astralis12/Cubesat/models/Activity Diagram (Telemetry Cycle).pdf

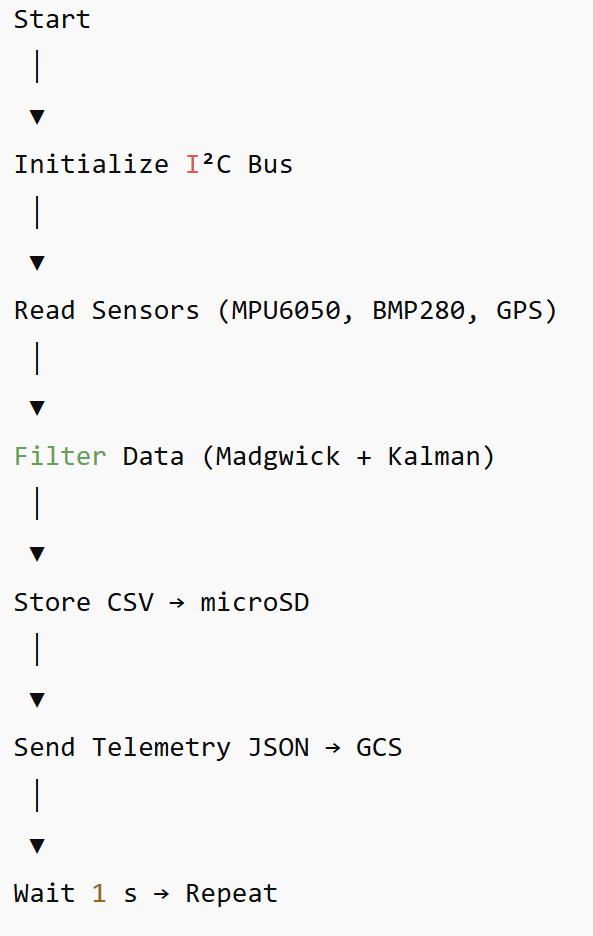
[picture p3: page 1]
