astralis12/Cubesat/models/Block Definition Diagramm.pdf

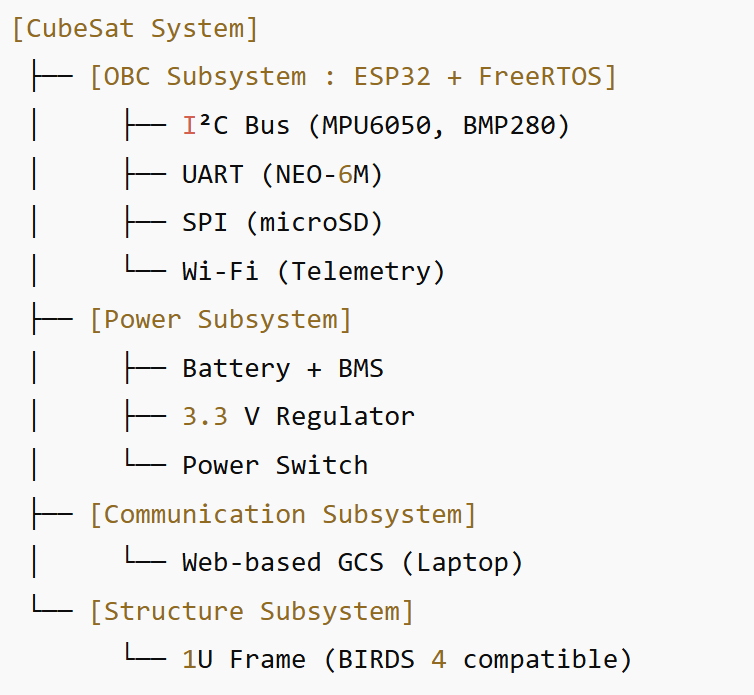
[picture p4: figure]
