astralis12/Cubesat/models/Finite State Machine Diagram.pdf

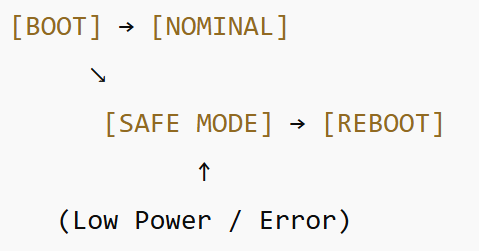
[picture p5: figure]
