astralis12/Cubesat/PCB Fix/board1_top_bom.csv

Comment | Designator | Footprint | LCSC Part #
470R | 3V3_RAIL 5V_RAIL BAT_RAIL MCU_LED R3 R4 | R0805
560R | R1 R2 | R0805
