astralis12/Cubesat/documents/RAS.xlsx

Resource Allocation Sheet
ID | Requirements description | Subsystem | verification method | Test ID
FR1 | CubeSat frame assembly and subsystem integration | Structure | Inspection | T01
FR2 | ESP32 must read IMU and BMP280 every 1 s via I²C | OBC | Test (oscilloscope, log check) | T02
FR3 | Data must be filtered and logged to microSD | OBC | Analysis + Test | T03
FR4 | Telemetry to GCS ≤5 s latency | OBC + COM | Test (Wi-Fi latency) | T04
FR5 | Power system stable 3.3 V ±5% | EPS | Measurement | T05
FR6 | System enters safe mode on low voltage | EPS + OBC | Demo (controlled test) | T06
