astralis12/Cubesat/Frame/cubesatV1.SLDASM

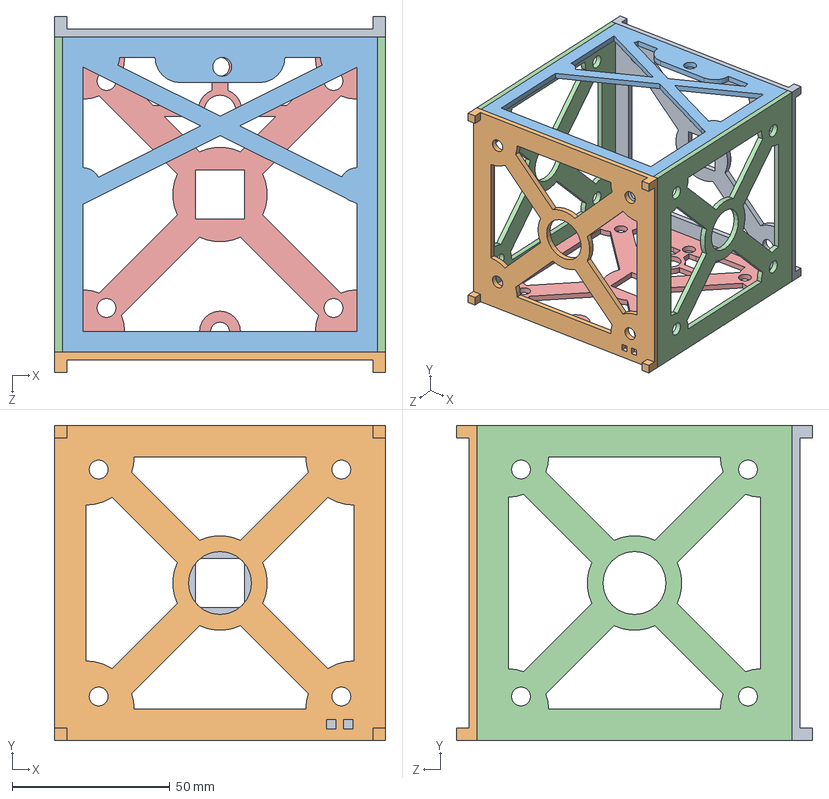
[picture p6: CAD file, 2026-09-21]
Frame/cubesatV1.SLDASM
105.0 x 100.0 x 113.0 mm
southernPart
sidePart x 2
northPart
downCover
topCover
