astralis12/Cubesat/Frame/mainBody.SLDASM

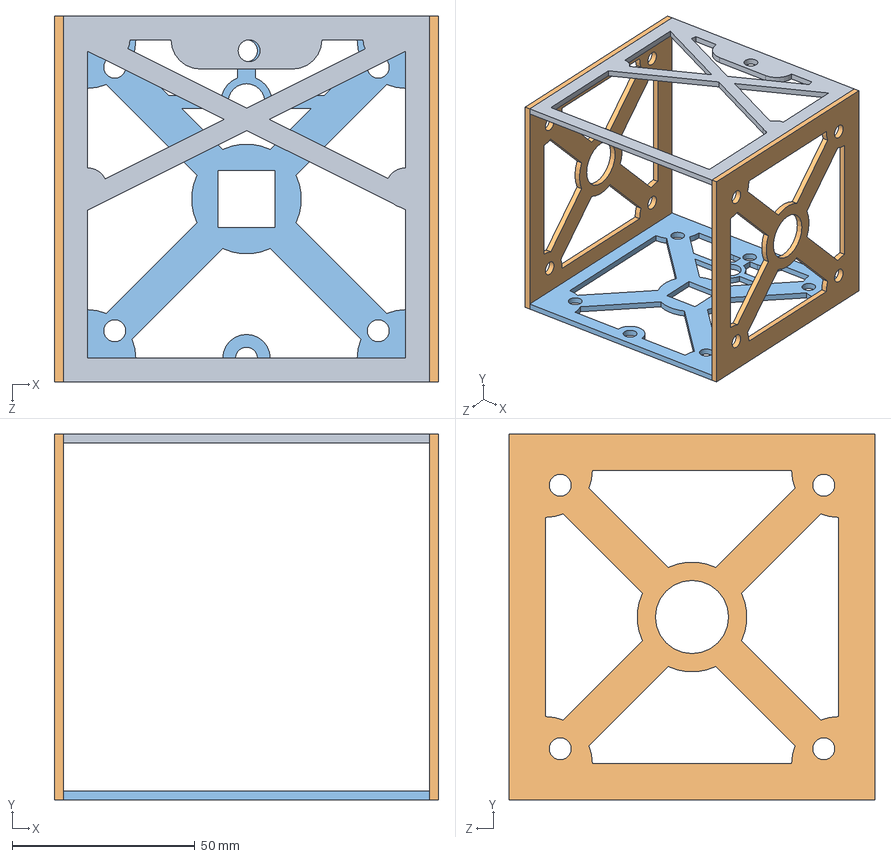
[picture p7: CAD file, 2026-09-21]
Frame/mainBody.SLDASM
105.0 x 100.0 x 100.0 mm
southernPart
sidePart x 2
northPart
