astralis12/Cubesat/printingFrame/B4_EM_frame6X v14.3mf

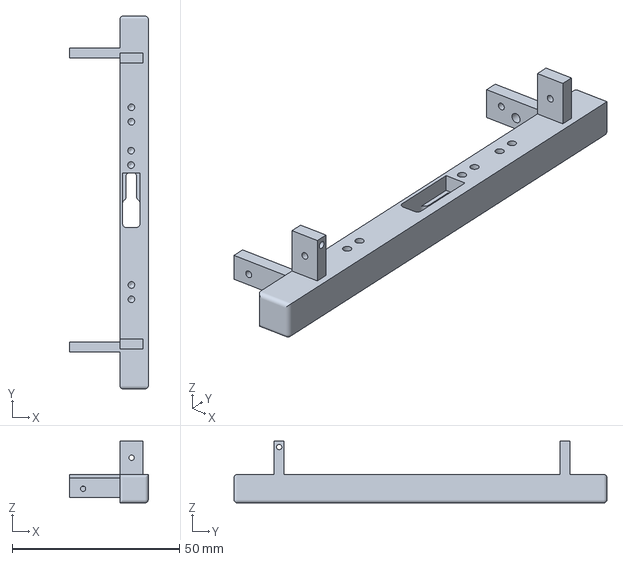
[picture p8: CAD file, 2026-09-21]
printingFrame/B4_EM_frame6X v14.3mf
23.5 x 111.5 x 18.5 mm
