astralis12/Cubesat/Frame/sidePart.SLDPRT

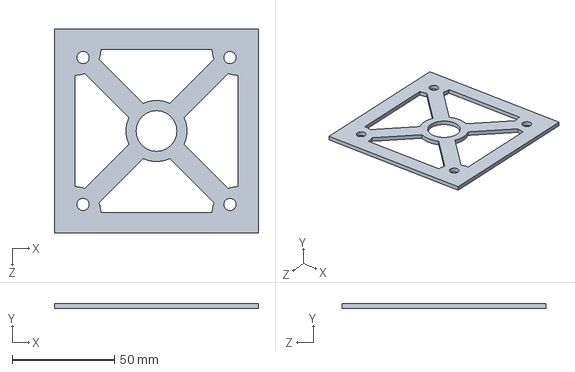
[picture p9: CAD file, 2026-09-21]
Frame/sidePart.SLDPRT
100.0 x 2.50 x 100.0 mm
