astralis12/Cubesat/printingFrame/B4_frame5A v29.3mf

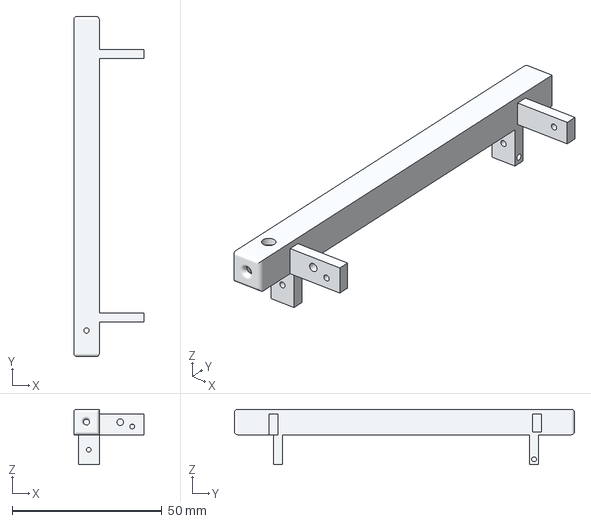
[picture p10: CAD file, 2026-09-21]
printingFrame/B4_frame5A v29.3mf
23.5 x 113.5 x 18.5 mm
