astralis12/Cubesat/Frame/northernPart.SLDPRT

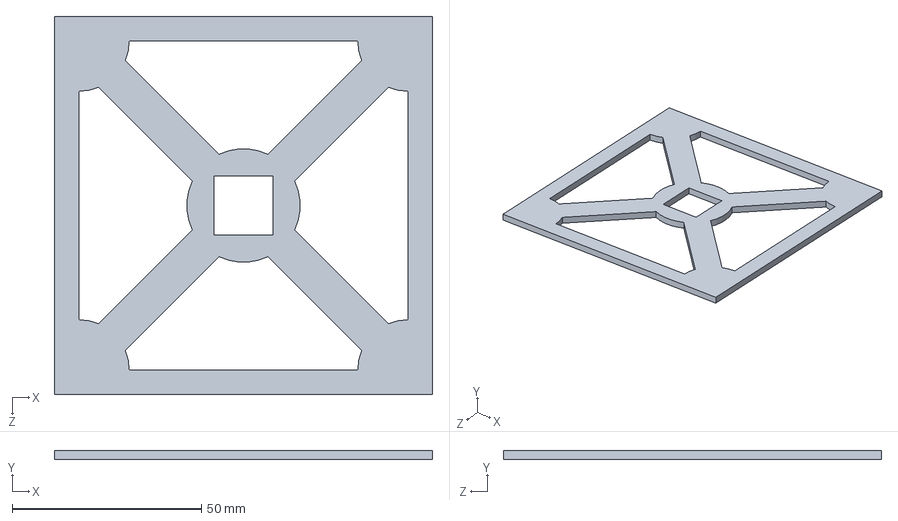
[picture p11: CAD file, 2026-09-21]
Frame/northernPart.SLDPRT
100.0 x 2.50 x 100.0 mm
