astralis12/Cubesat/printingFrame/B4_frame2 v6.3mf

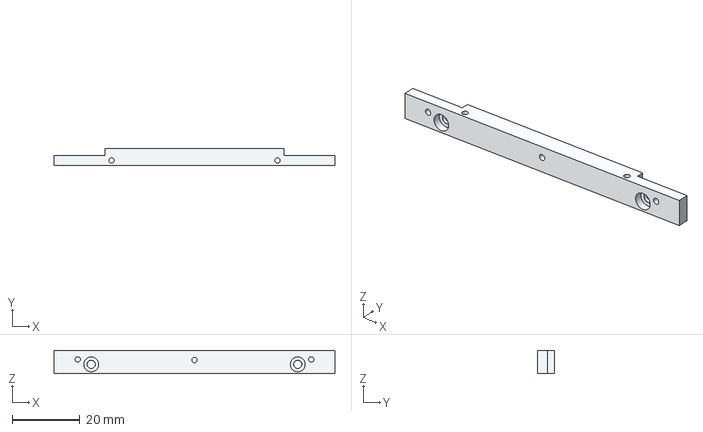
[picture p12: CAD file, 2026-09-21]
printingFrame/B4_frame2 v6.3mf
83.0 x 5.00 x 6.90 mm
