astralis12/Cubesat/Frame/topCover.SLDPRT

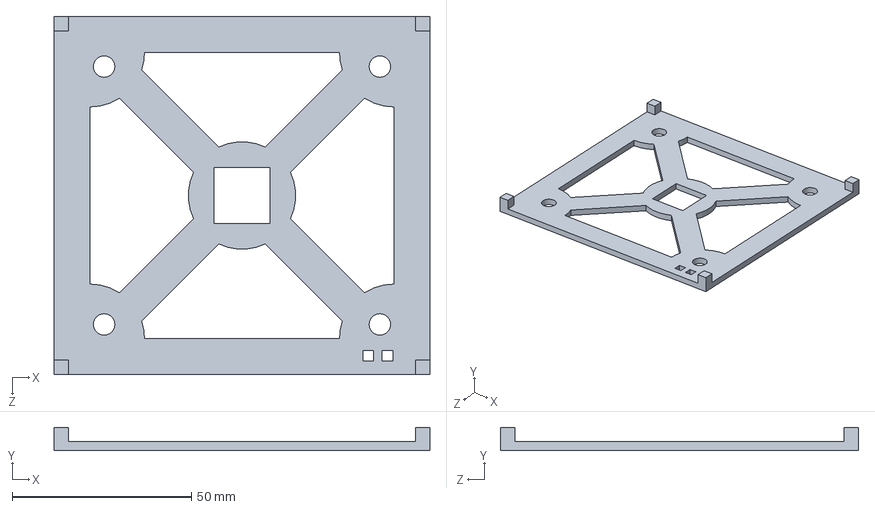
[picture p13: CAD file, 2026-09-21]
Frame/topCover.SLDPRT
105.0 x 6.50 x 100.0 mm
