astralis12/Cubesat/printingFrame/B4_frame1F v12.3mf

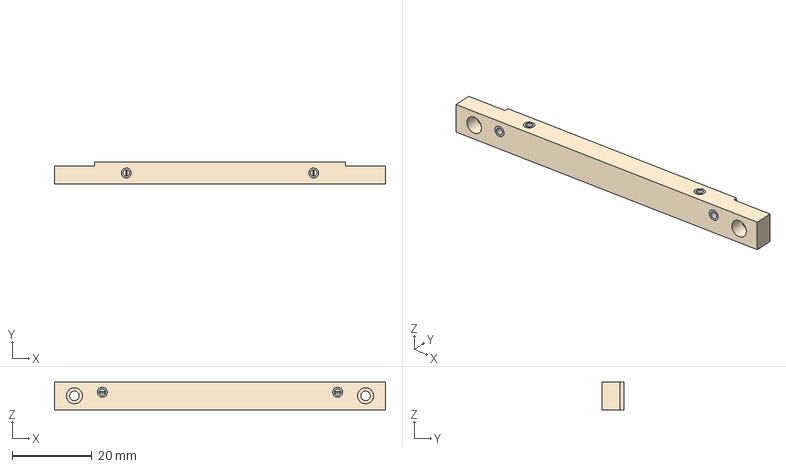
[picture p14: CAD file, 2026-09-21]
printingFrame/B4_frame1F v12.3mf
83.0 x 5.50 x 6.90 mm
