astralis12/Cubesat/Frame/southernPart.SLDPRT

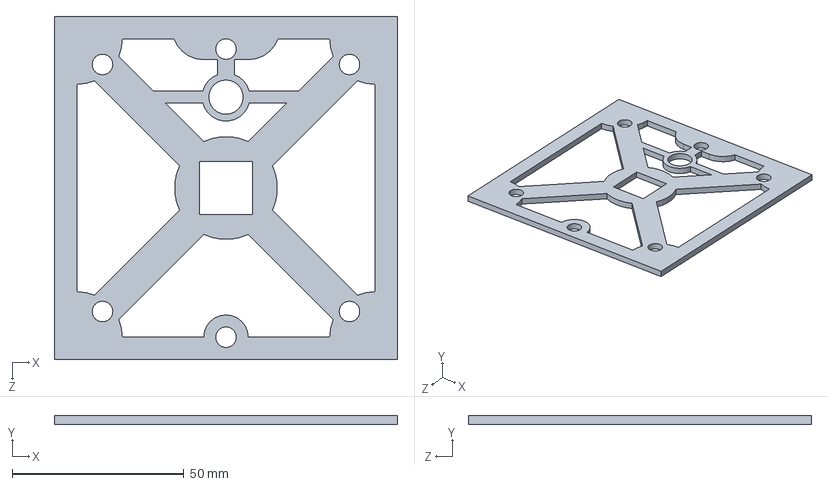
[picture p15: CAD file, 2026-09-21]
Frame/southernPart.SLDPRT
100.0 x 2.50 x 100.0 mm
