astralis12/Cubesat/printingFrame/B4_frame2S v15.3mf

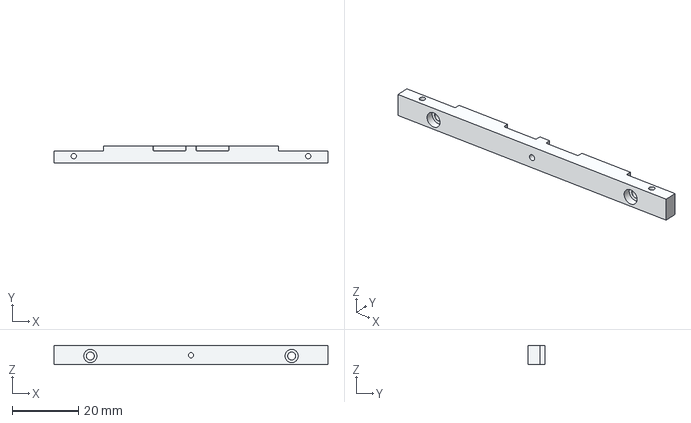
[picture p16: CAD file, 2026-09-21]
printingFrame/B4_frame2S v15.3mf
83.0 x 5.00 x 5.90 mm
