astralis12/Cubesat/Frame/bodyFix.SLDPRT

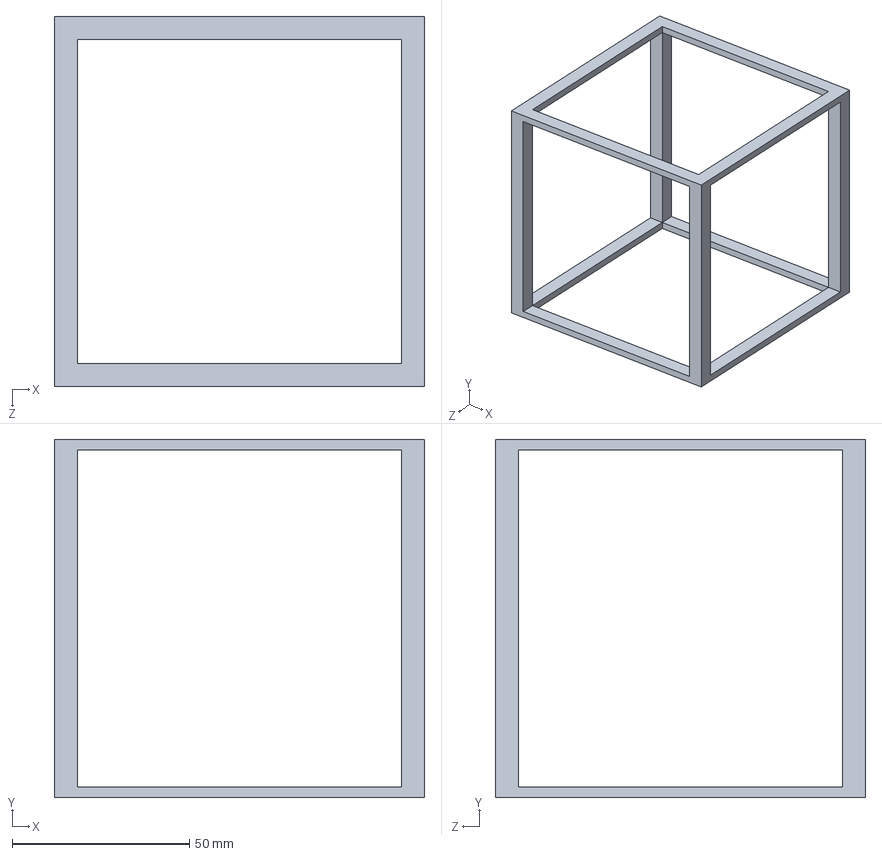
[picture p17: CAD file, 2026-09-21]
Frame/bodyFix.SLDPRT
104.4 x 101.0 x 104.4 mm
