astralis12/Cubesat/printingFrame/B4_frame4 v8.3mf

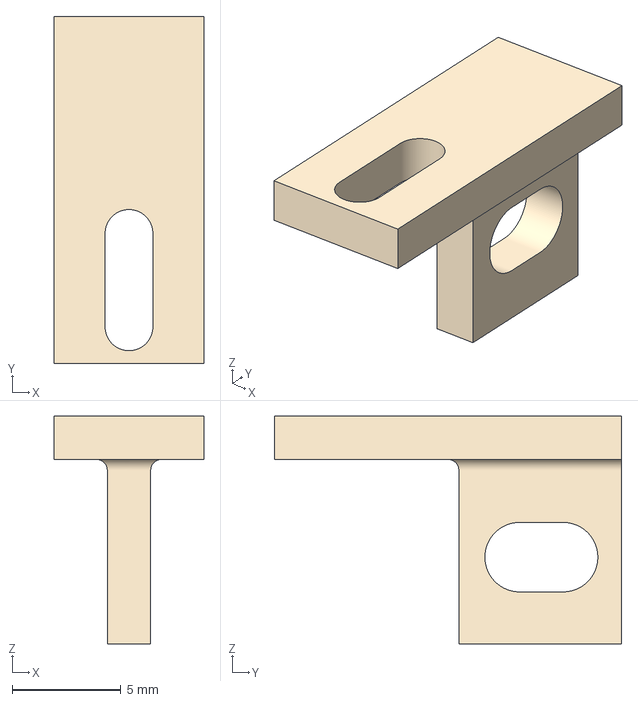
[picture p18: CAD file, 2026-09-21]
printingFrame/B4_frame4 v8.3mf
6.90 x 16.0 x 10.5 mm
