astralis12/Cubesat/Frame/solarPanel11x7x3.SLDPRT

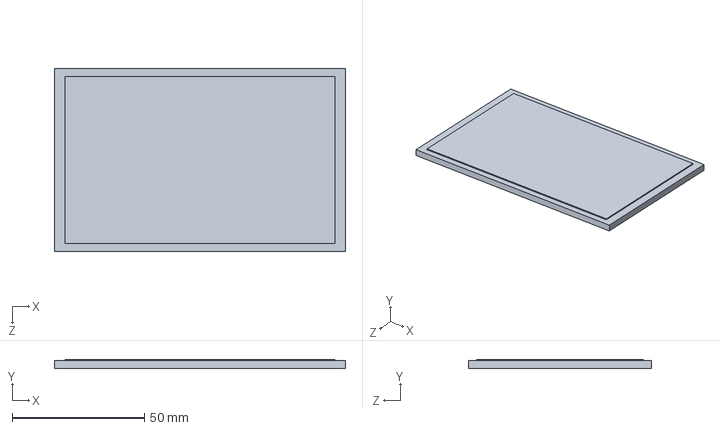
[picture p19: CAD file, 2026-09-21]
Frame/solarPanel11x7x3.SLDPRT
110.0 x 3.50 x 69.0 mm
