astralis12/Cubesat/printingFrame/B4_frame7_updated_after_FM v2.3mf

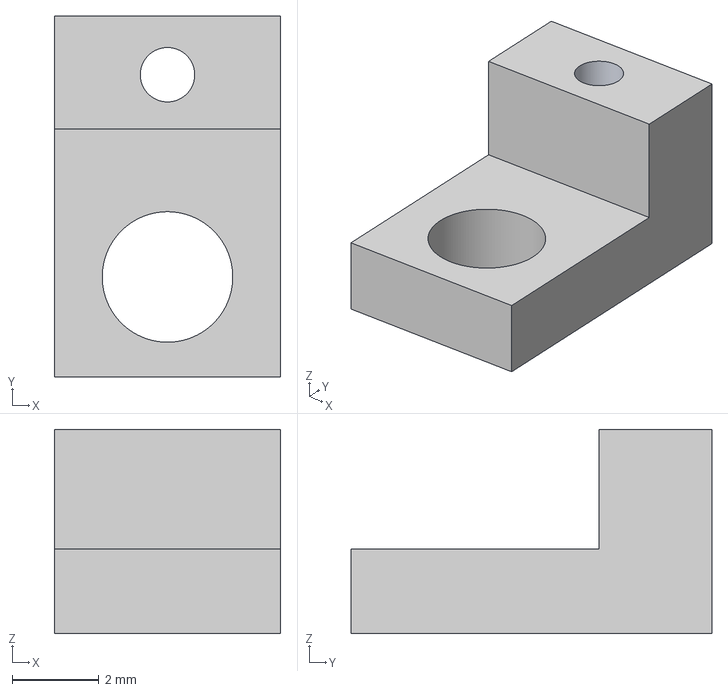
[picture p20: CAD file, 2026-09-21]
printingFrame/B4_frame7_updated_after_FM v2.3mf
5.20 x 8.30 x 4.70 mm
