astralis12/Cubesat/Frame/SAM-M8Q gps.SLDPRT

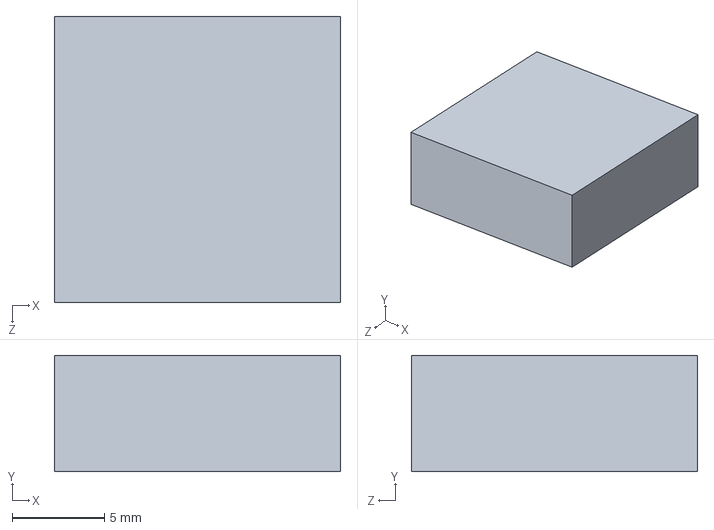
[picture p21: CAD file, 2026-09-21]
Frame/SAM-M8Q gps.SLDPRT
15.5 x 6.30 x 15.5 mm
