astralis12/Cubesat/Frame/northPart.SLDPRT

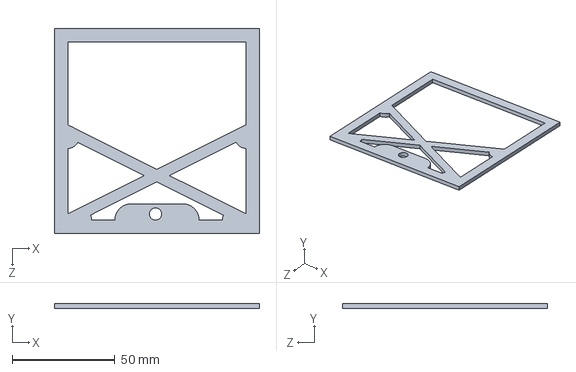
[picture p22: CAD file, 2026-09-21]
Frame/northPart.SLDPRT
100.0 x 2.50 x 100.0 mm
