astralis12/Cubesat/(list of files, cad)

Other CAD files:
Frame/cubesat.SLDASM
printingFrame/design/B4_frame6Y v15.gcode.3mf
printingFrame/design/new/ALLv1.gcode.3mf
printingFrame/design/B4_frame2S v15.gcode.3mf
printingFrame/design/new/BODYv1.gcode.3mf
printingFrame/design/B4_frame4 v8.gcode.3mf
printingFrame/design/new/TOP.gcode.3mf
printingFrame/design/B4_frame5B v14.gcode.3mf
printingFrame/B4_frame5B v14.3mf
printingFrame/design/B4_frame1 v6.gcode.3mf
Frame/downCover.SLDPRT
printingFrame/design/B4_frame5A v29.gcode.3mf
printingFrame/B4_frame3 v15.3mf
printingFrame/design/B4_frame2 v6.gcode.3mf
printingFrame/B4_frame6Y v15.3mf
printingFrame/design/B4_EM_frame6X v14.gcode.3mf
printingFrame/B4_frame1 v6.3mf
Frame/cubesat.3mf
