astralis12/Cubesat/documents/Verification & Validation Plan.xlsx

Verification & Validation Plan
Req ID | Verification Type | Verification Method | Acceptance Criteria | Result
FR1 | Inspection | Visual inspection of 3D-printed frame assembly | All components fit 1U frame | -
FR2 | Test | Log timestamp difference between two I²C reads | Interval ≤ 1 s | -
FR3 | Test + Analysis | Compare filtered vs. raw data logs | RMS error ≤ 5% | -
FR4 | Demo | Measure delay from OBC packet → GCS display | < 5 s latency | -
FR5 | Measurement | Voltage reading under load | 3.3 V ±5% | -
FR6 | Demo | Trigger low battery simulation | System enters safe mode | -
