astralis12/Cubesat/PCB Fix/Skematik(Sementara).pdf

# 3V3 1 ESP32-DEVKITV1

## Solar Charge Controller

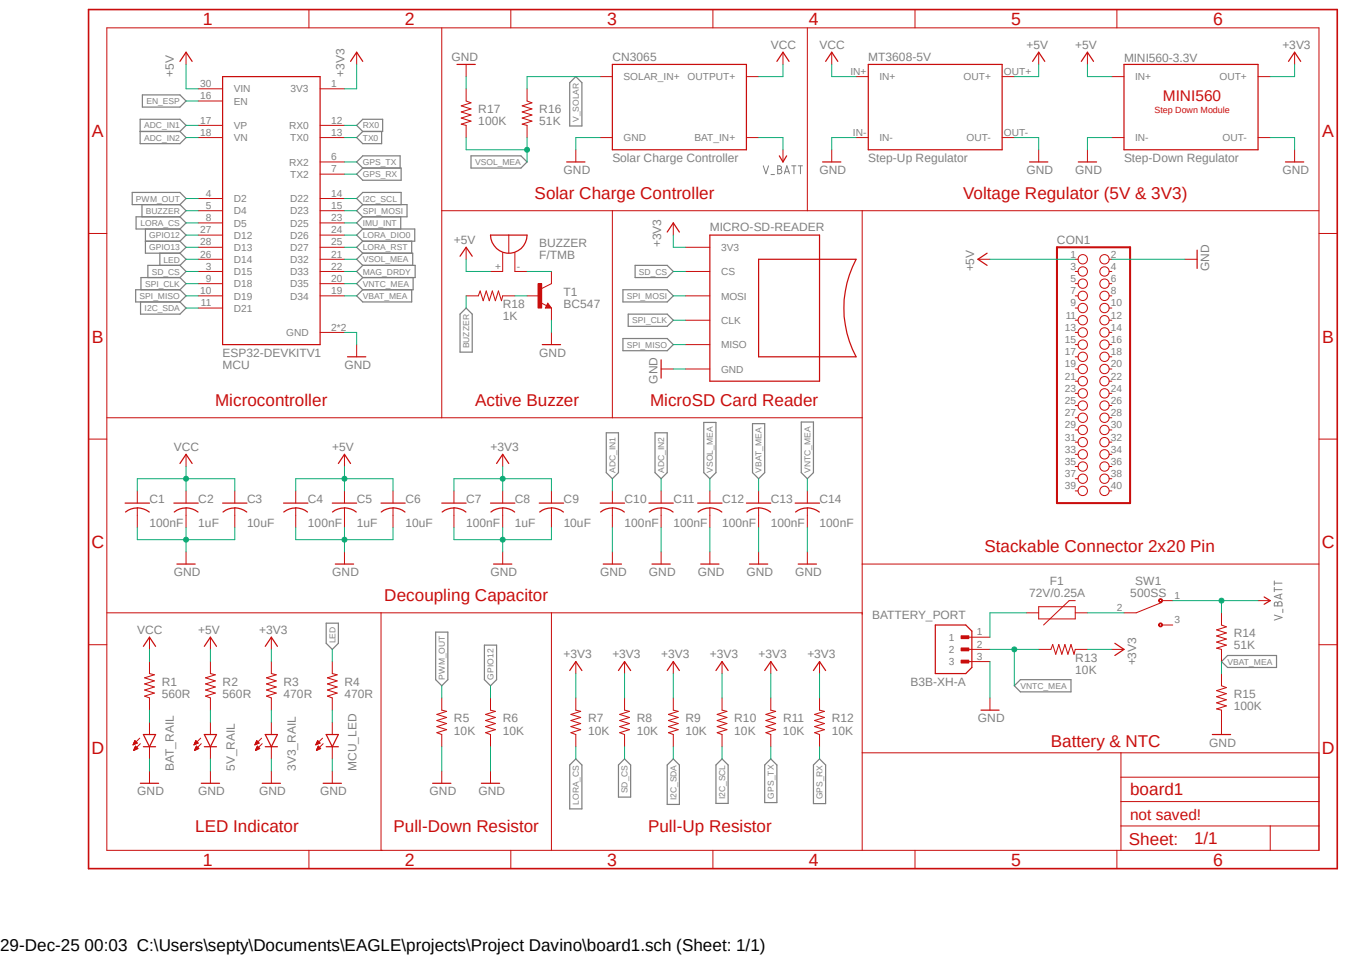
[picture p23: page 1]

VCC | VCC +5V +5V +3V3 Voltage Regulator (5V & 3V3)

29-Dec-25 00:03 C:\Users\septy\Documents\EAGLE\projects\Project Davino\board1.sch (Sheet: 1/1)
