astralis12/Cubesat/PCB Fix/board1.pdf

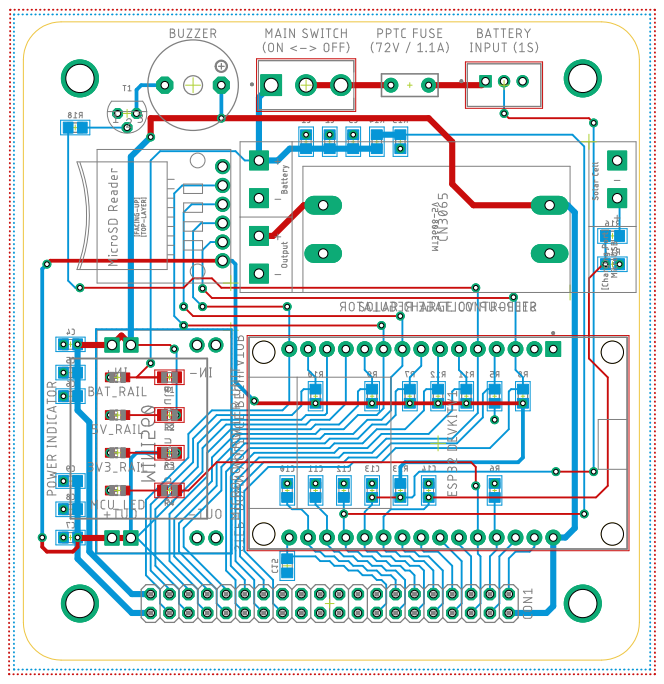
[picture p24: page 1]
