astralis12/Cubesat/board2v2/board2v2.kicad_pcb

## KiCad design board2v2/board2v2.kicad_pcb (2026-09-21)

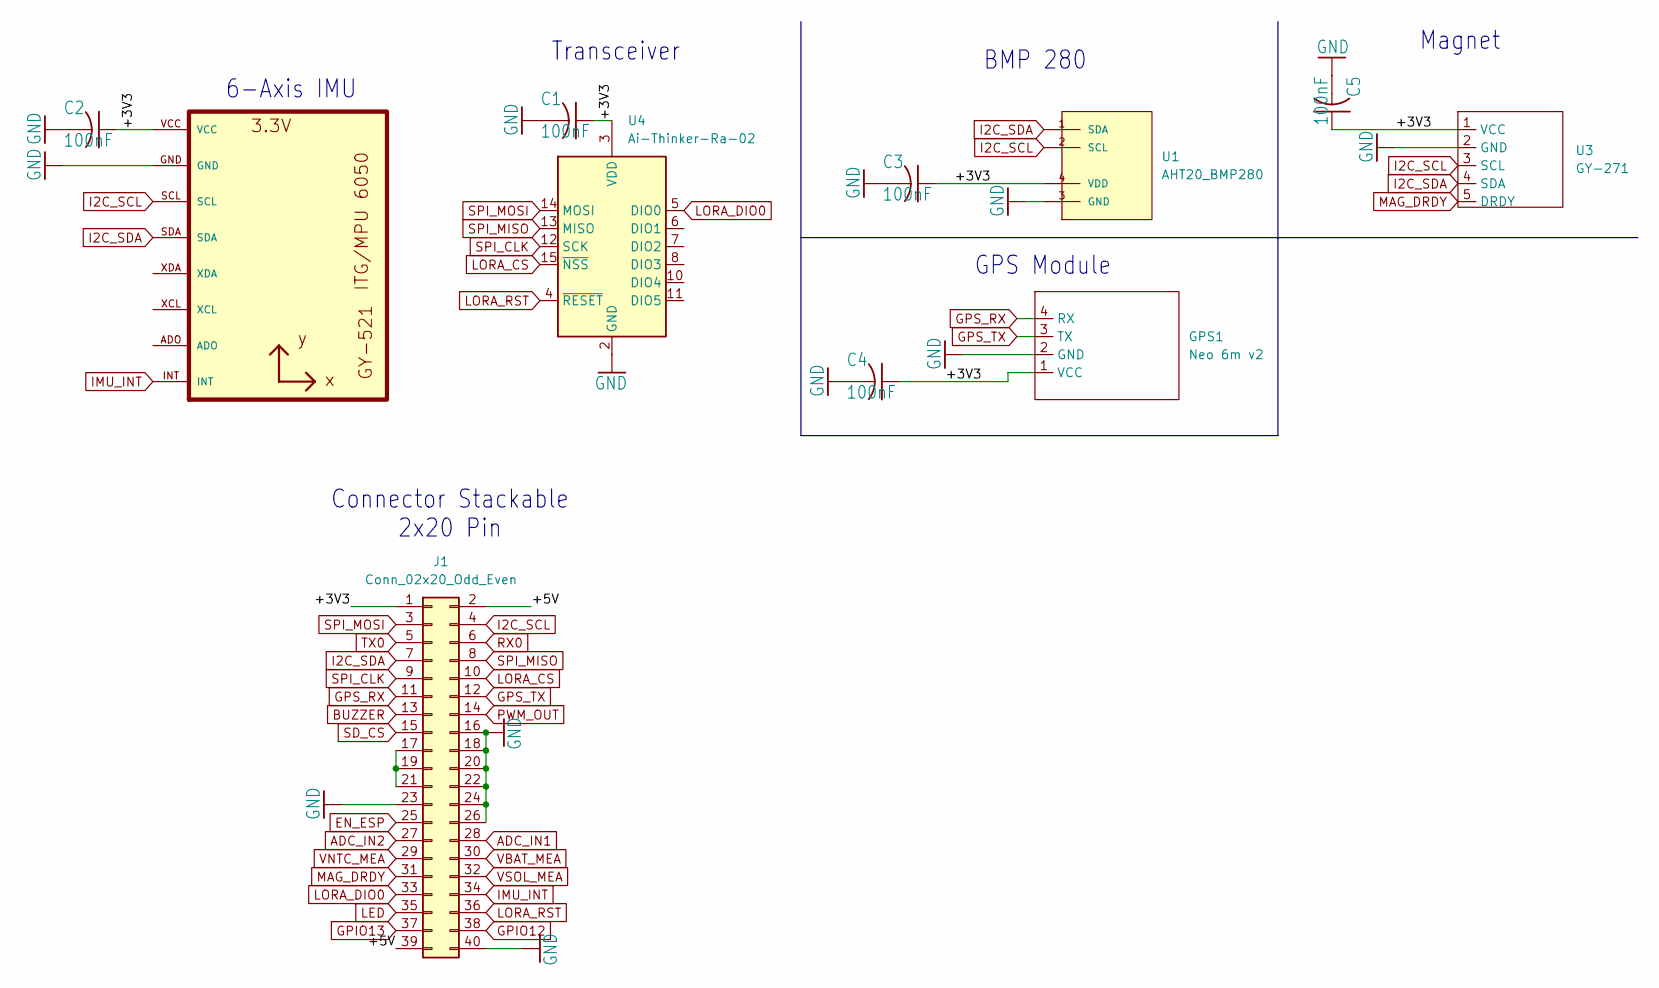
[picture p25: schematic board2v2.kicad_sch]

Parts:
C1, C2, C3, C4, C5: 100nF; C_0805_2012Metric_Pad1.18x1.45mm_HandSolder
GPS1: Neo 6m v2; NEO-6M-V2
J1: Conn_02x20_Odd_Even; PinSocket_2x20_P2.54mm_Vertical
U1: AHT20_BMP280
U2: GY-521
U3: GY-271
U4: Ai-Thinker-Ra-02; LORA SX1278 RA-02 WIRELESS MODULE

Connections:
/+3V3: C1.1, C2.1, C3.1, C4.1, C5.1, GPS1.1 (VCC), J1.1, U1.4 (VDD), U2.VCC, U3.1 (VCC), U4.3 (VDD)
/+5V: J1.2, J1.39
ADC_IN1: J1.28
ADC_IN2: J1.27
BUZZER: J1.13
EN_ESP: J1.25
GND: C1.2, C2.2, C3.2, C4.2, C5.2, GPS1.2 (GND), J1.16, J1.18, J1.20, J1.22, J1.23, J1.24, J1.26, J1.40, U1.3 (GND), U2.GND, U3.2 (GND), U4.1 (GND), U4.2 (GND), U4.9 (GND), U4.16 (GND)
GPIO12: J1.38
GPIO13: J1.37
GPS_RX: GPS1.4 (RX), J1.11
GPS_TX: GPS1.3 (TX), J1.12
I2C_SCL: J1.4, U1.2 (SCL), U2.SCL, U3.3 (SCL)
I2C_SDA: J1.7, U1.1 (SDA), U2.SDA, U3.4 (SDA)
IMU_INT: J1.34, U2.INT
LED: J1.35
LORA_CS: J1.10, U4.15 (~NSS)
LORA_DIO0: J1.33, U4.5 (DIO0)
LORA_RST: J1.36, U4.4 (~RESET)
MAG_DRDY: J1.31, U3.5 (DRDY)
unnamed: J1.17, J1.19, J1.21
PWM_OUT: J1.14
RX0: J1.6
SD_CS: J1.15
SPI_CLK: J1.9, U4.12 (SCK)
SPI_MISO: J1.8, U4.13 (MISO)
SPI_MOSI: J1.3, U4.14 (MOSI)
TX0: J1.5
VBAT_MEA: J1.30
VNTC_MEA: J1.29
VSOL_MEA: J1.32

Notes on the sheet:
Magnet
GPS Module
Transceiver
6-Axis IMU
BMP 280
Connector Stackable 2x20 Pin

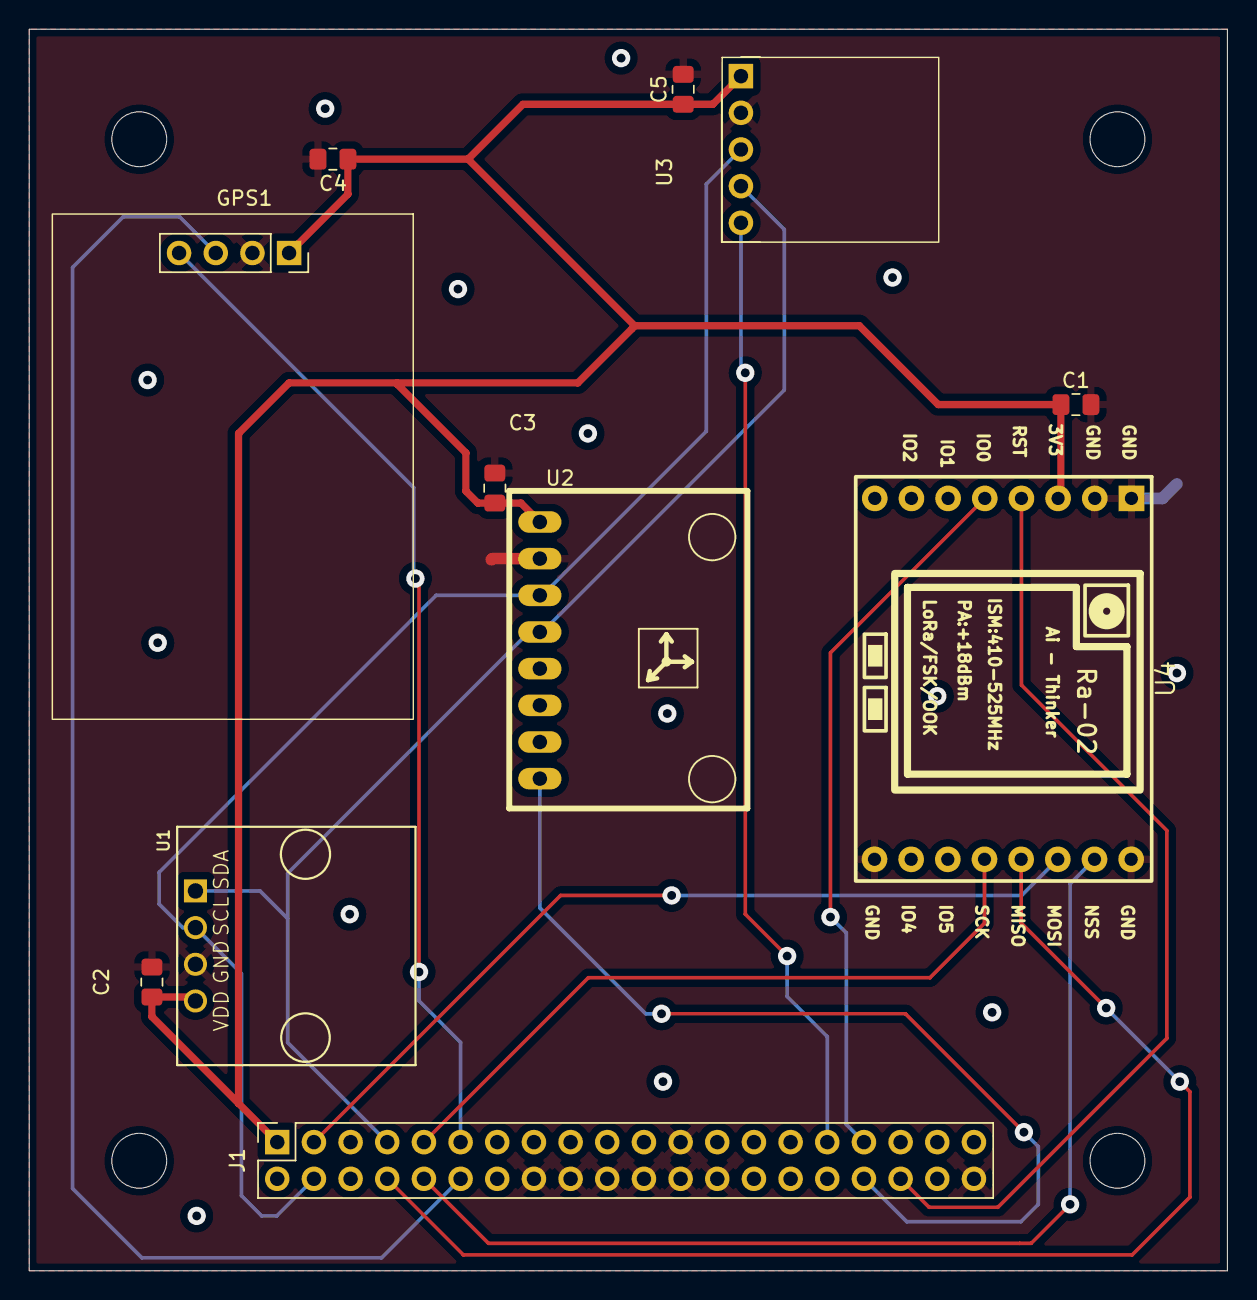
[picture p26: board board2v2.kicad_pcb from above]

Board: 2 copper layers, 83.0 x 86.0 mm, 11 parts (0 on the bottom side), 16 nets.
