astralis12/Cubesat/PCB Fix/board1.brd

## EAGLE design PCB Fix/board1.brd (2026-09-21)

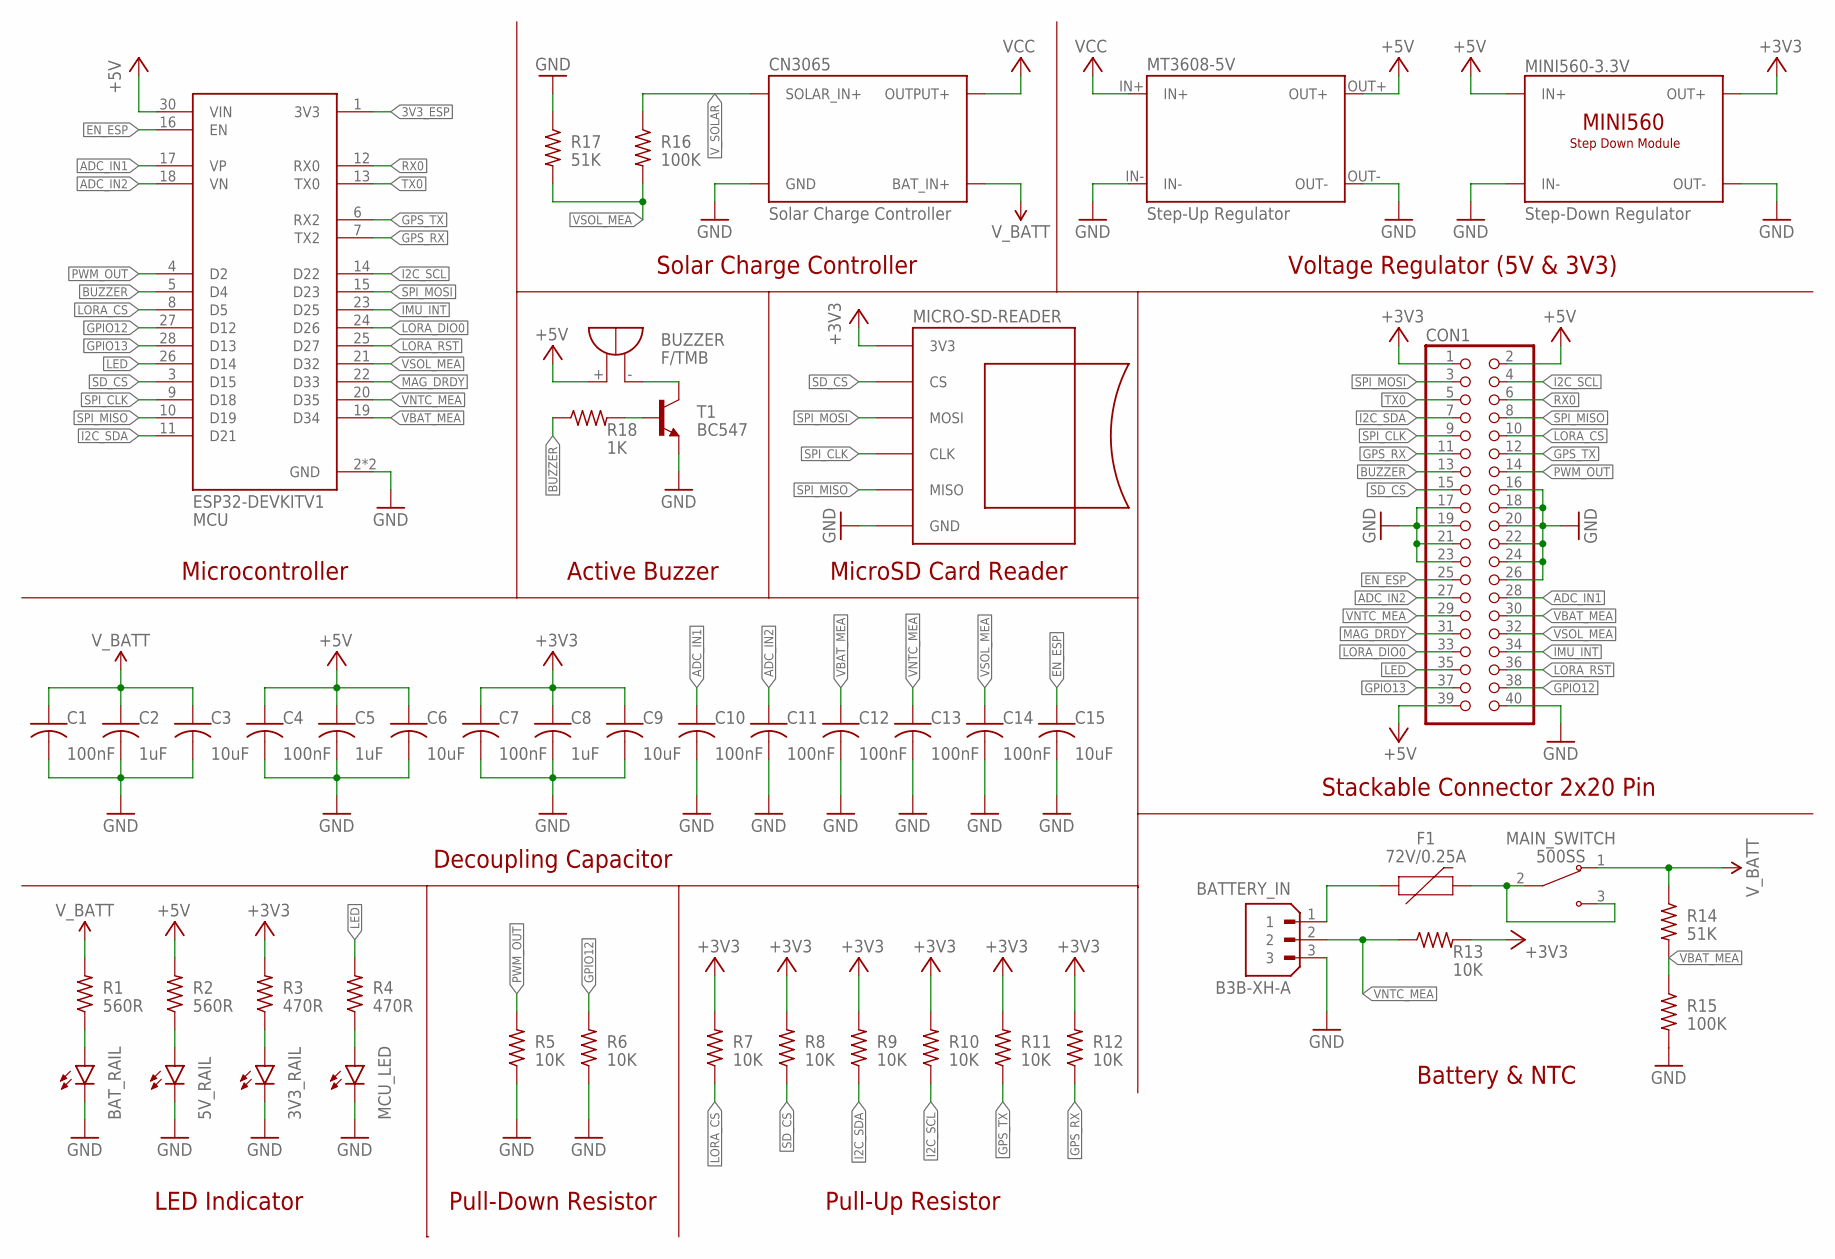
[picture p27: schematic board1.sch]

Parts:
3V3_RAIL, 5V_RAIL: LEDCHIP-LED0805; CHIP-LED0805
BATTERY_IN: B3B-XH-A; JST_B3B-XH-A
BAT_RAIL: LEDCHIP-LED0805; CHIP-LED0805
BUZZER: F/TMB
C1, C4, C7, C10, C11, C12, C13, C14: 100nF; C0805
C2, C5, C8: 1uF; C0805
C3, C6, C9, C15: 10uF; C0805
CN3065: Solar Charge Controller; CN3065
CON1: PINHD-2X20; 2X20
ESP32-DEVKITV1: MCU; MODULE_ESP32_DEVKIT_V1
F1: 72V/0.25A; PTH
MAIN_SWITCH: 500SS; SW_500SSP1S1M2REA
MCU_LED: LEDCHIP-LED0805; CHIP-LED0805
MICRO-SD-READER: MICROSD-READERUP-TOP; MICROSD-READER-FACING_UP(TOP_LAYER)
MINI560-3.3V: Step-Down Regulator; MINI560-THT
MT3608-5V: Step-Up Regulator; MT3608
R1, R2: 560R; R0805
R3, R4: 470R; R0805
R5, R6, R7, R8, R9, R10, R11, R12, R13: 10K; R0805
R14, R17: 51K; R0805
R15, R16: 100K; R0805
R18: 1K; R0805
T1: BC547; TO92

Connections:
3V3_ESP: ESP32-DEVKITV1.1 (3V3)
+3V3: C7.1, C8.1, C9.1, CON1.1, MICRO-SD-READER.3V3, MINI560-3.3V.1OUT+ (OUT+), MINI560-3.3V.2OUT+ (OUT+), R3.2, R7.2, R8.2, R9.2, R10.2, R11.2, R12.2, R13.2
+5V: BUZZER.+, C4.1, C5.1, C6.1, CON1.2, CON1.39, ESP32-DEVKITV1.30 (VIN), MINI560-3.3V.1IN+ (IN+), MINI560-3.3V.2IN+ (IN+), MT3608-5V.OUT+, R2.2
ADC_IN1: C10.1, CON1.28, ESP32-DEVKITV1.17 (VP)
ADC_IN2: C11.1, CON1.27, ESP32-DEVKITV1.18 (VN)
BUZZER: CON1.13, ESP32-DEVKITV1.5 (D4), R18.1
EN_ESP: C15.1, CON1.25, ESP32-DEVKITV1.16 (EN)
GND: 3V3_RAIL.C, 5V_RAIL.C, BATTERY_IN.3, BAT_RAIL.C, C1.2, C2.2, C3.2, C4.2, C5.2, C6.2, C7.2, C8.2, C9.2, C10.2, C11.2, C12.2, C13.2, C14.2, C15.2, CN3065.BAT- (GND), CN3065.OUT- (GND), CN3065.SC- (GND), CON1.16, CON1.17, CON1.18, CON1.19, CON1.20, CON1.21, CON1.22, CON1.23, CON1.24, CON1.26, CON1.40, ESP32-DEVKITV1.2 (GND), ESP32-DEVKITV1.29 (GND), MCU_LED.C, MICRO-SD-READER.GND, MINI560-3.3V.1IN- (IN-), MINI560-3.3V.1OUT- (OUT-), MINI560-3.3V.2IN- (IN-), MINI560-3.3V.2OUT- (OUT-), MT3608-5V.IN-, MT3608-5V.OUT-, R5.1, R6.1, R15.2, R17.1, T1.1 (E)
GPIO12: CON1.38, ESP32-DEVKITV1.27 (D12), R6.2
GPIO13: CON1.37, ESP32-DEVKITV1.28 (D13)
GPS_RX: CON1.11, ESP32-DEVKITV1.7 (TX2), R12.1
GPS_TX: CON1.12, ESP32-DEVKITV1.6 (RX2), R11.1
I2C_SCL: CON1.4, ESP32-DEVKITV1.14 (D22), R10.1
I2C_SDA: CON1.7, ESP32-DEVKITV1.11 (D21), R9.1
IMU_INT: CON1.34, ESP32-DEVKITV1.23 (D25)
LED: CON1.35, ESP32-DEVKITV1.26 (D14), R4.2
LORA_CS: CON1.10, ESP32-DEVKITV1.8 (D5), R7.1
LORA_DIO0: CON1.33, ESP32-DEVKITV1.24 (D26)
LORA_RST: CON1.36, ESP32-DEVKITV1.25 (D27)
MAG_DRDY: CON1.31, ESP32-DEVKITV1.22 (D33)
unnamed: BATTERY_IN.1, F1.P$1 (1)
unnamed: BUZZER.-, T1.3 (C)
unnamed: F1.P$2 (2), MAIN_SWITCH.2 (COM), MAIN_SWITCH.3 (NO)
unnamed: R18.2, T1.2 (B)
unnamed: MCU_LED.A, R4.1
unnamed: 3V3_RAIL.A, R3.1
unnamed: BAT_RAIL.A, R1.1
unnamed: 5V_RAIL.A, R2.1
PWM_OUT: CON1.14, ESP32-DEVKITV1.4 (D2), R5.2
RX0: CON1.6, ESP32-DEVKITV1.12 (RX0)
SD_CS: CON1.15, ESP32-DEVKITV1.3 (D15), MICRO-SD-READER.CS, R8.1
SPI_CLK: CON1.9, ESP32-DEVKITV1.9 (D18), MICRO-SD-READER.CLK
SPI_MISO: CON1.8, ESP32-DEVKITV1.10 (D19), MICRO-SD-READER.MISO
SPI_MOSI: CON1.3, ESP32-DEVKITV1.15 (D23), MICRO-SD-READER.MOSI
TX0: CON1.5, ESP32-DEVKITV1.13 (TX0)
VBAT_MEA: C12.1, CON1.30, ESP32-DEVKITV1.19 (D34), R14.2, R15.1
VCC: CN3065.OUT+ (OUTPUT+), MT3608-5V.IN+
VNTC_MEA: BATTERY_IN.2, C13.1, CON1.29, ESP32-DEVKITV1.20 (D35), R13.1
VSOL_MEA: C14.1, CON1.32, ESP32-DEVKITV1.21 (D32), R16.2, R17.2
V_BATT: C1.1, C2.1, C3.1, CN3065.BAT+ (BAT_IN+), MAIN_SWITCH.1 (NC), R1.2, R14.1
V_SOLAR: CN3065.SC+ (SOLAR_IN+), R16.1

Notes on the sheet:
Microcontroller
Decoupling Capacitor
LED Indicator
Pull-Down Resistor
Pull-Up Resistor
Battery & NTC
Active Buzzer
MicroSD Card Reader
Solar Charge Controller
Stackable Connector 2x20 Pin
Voltage Regulator (5V & 3V3)

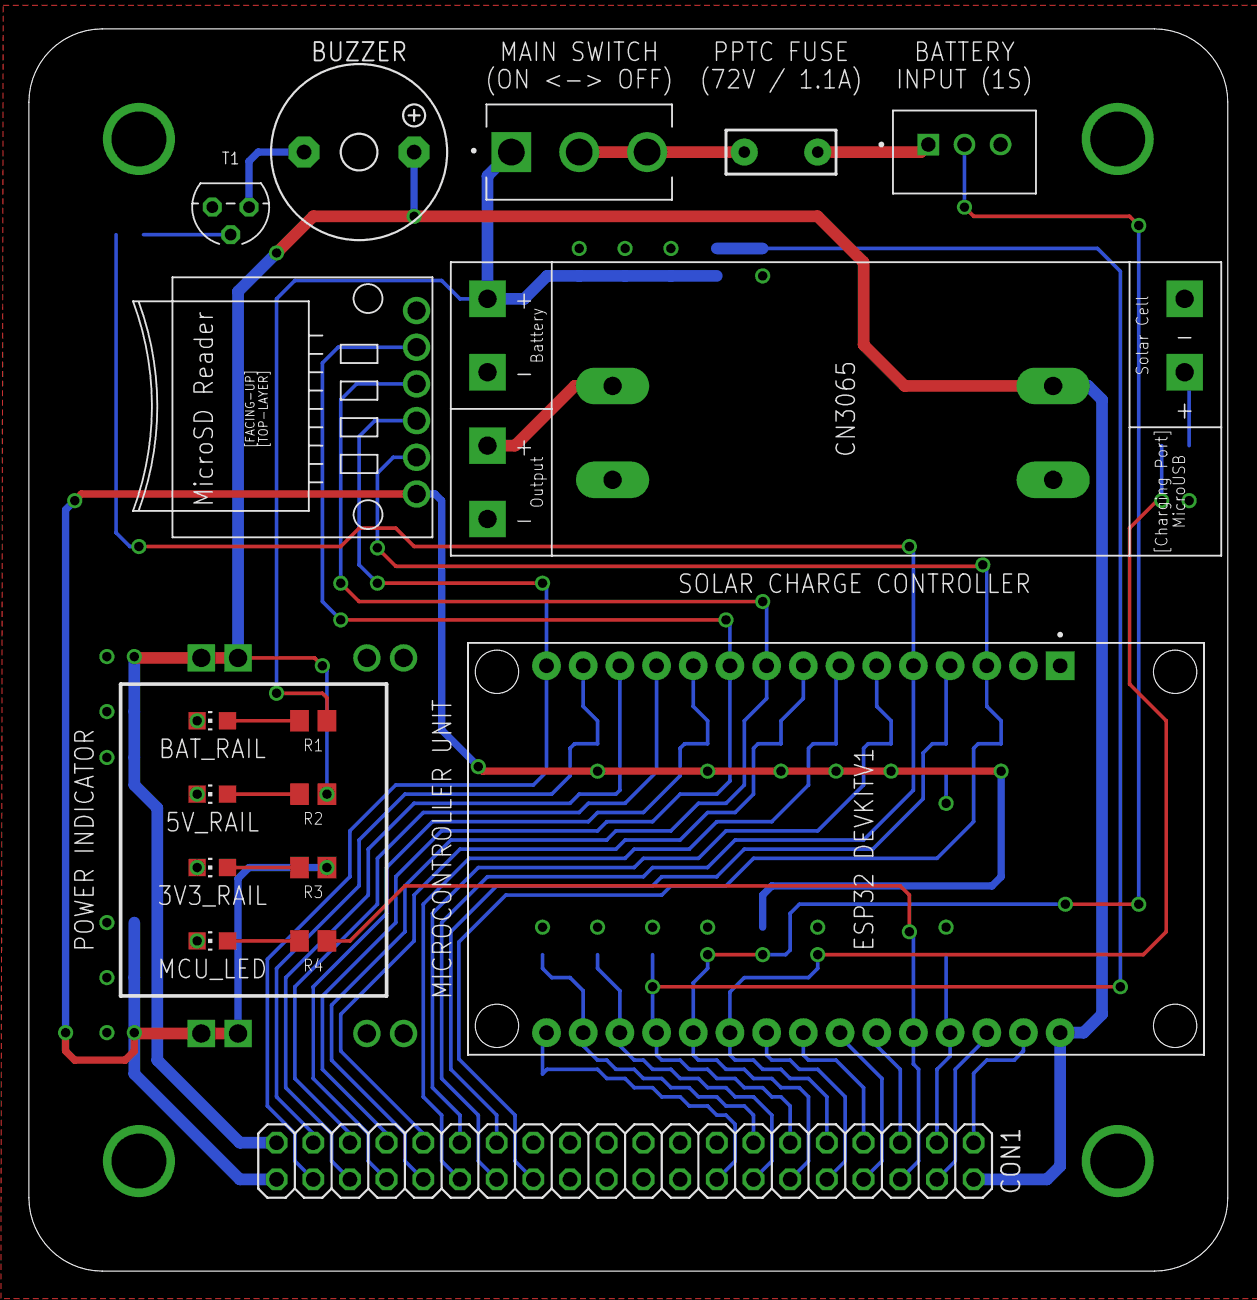
[picture p28: board board1.brd from above]

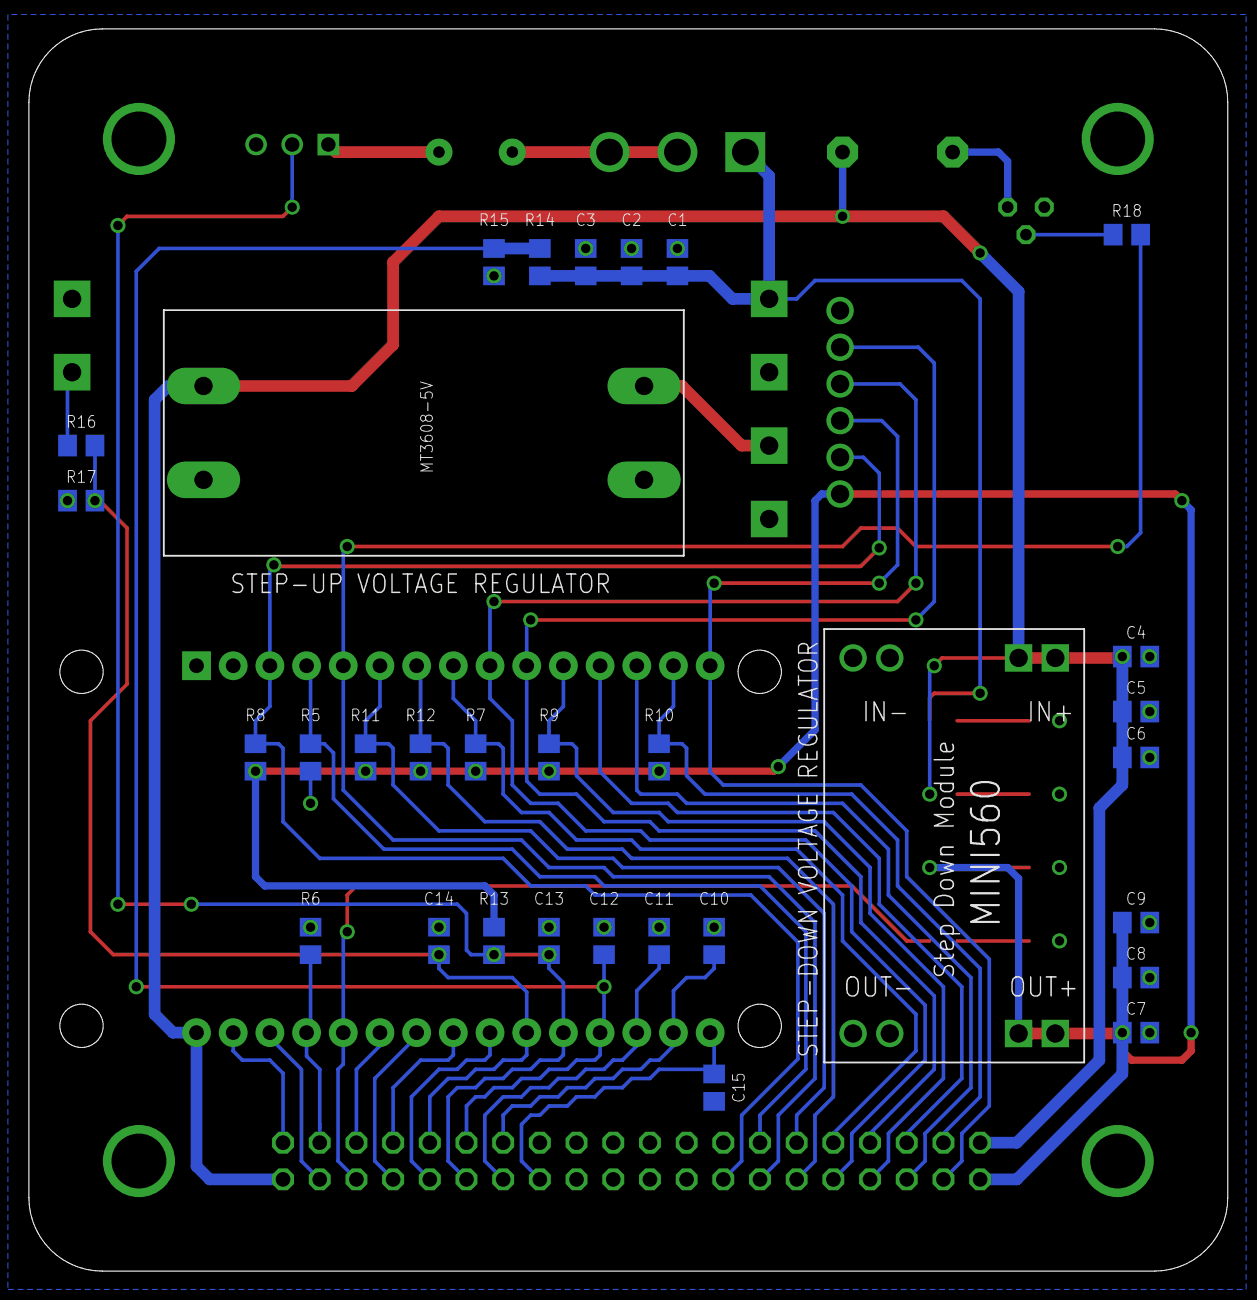
[picture p29: board board1.brd from below]

Board: 2 copper layers, 83.0 x 86.0 mm, 48 parts (31 on the bottom side), 40 nets.
