astralis12/Cubesat/(commit log)

2025-10-12 0 MBSE backbone v1
    [RAS.xlsx, Verification & Validation Plan.xlsx]
2025-11-29 Printed OBC and EPS
    double layer minus the interface documentation
